tanishka-0/stm32_competition/PCB/3D.png

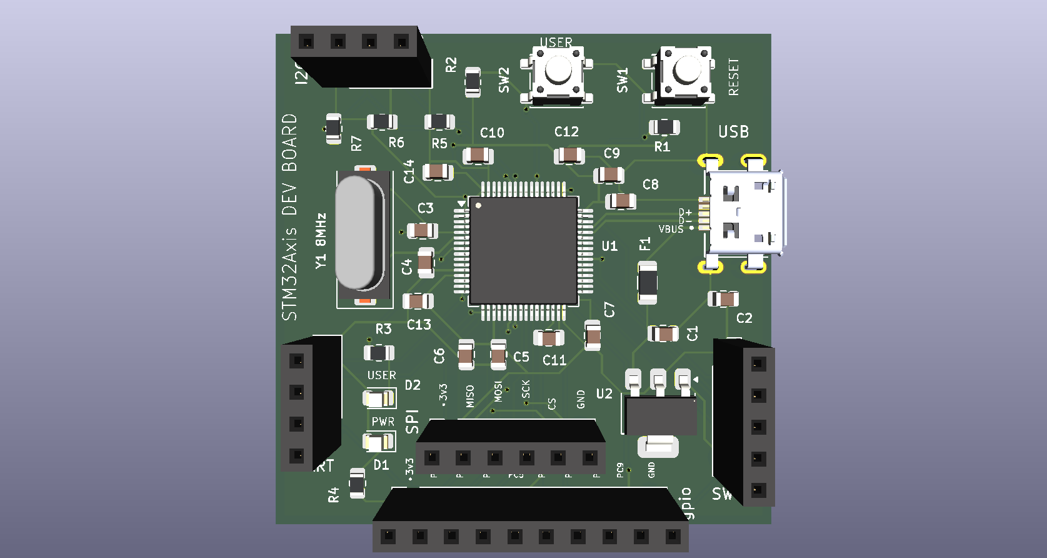
PCB/3D.png
