tanishka-0/stm32_competition/Documentation/DocumentReport.pdf

# STM32Axis Development Board

## Custom STM32F401RET6 Development Board made by team

## ERROR 505

### Project Documentation — Schematic, PCB Design, BOM & Validation Repository: github.com/tanishka-0/stm32axis

STM32Axis Development Board — Documentation | Page

## 1. Overview

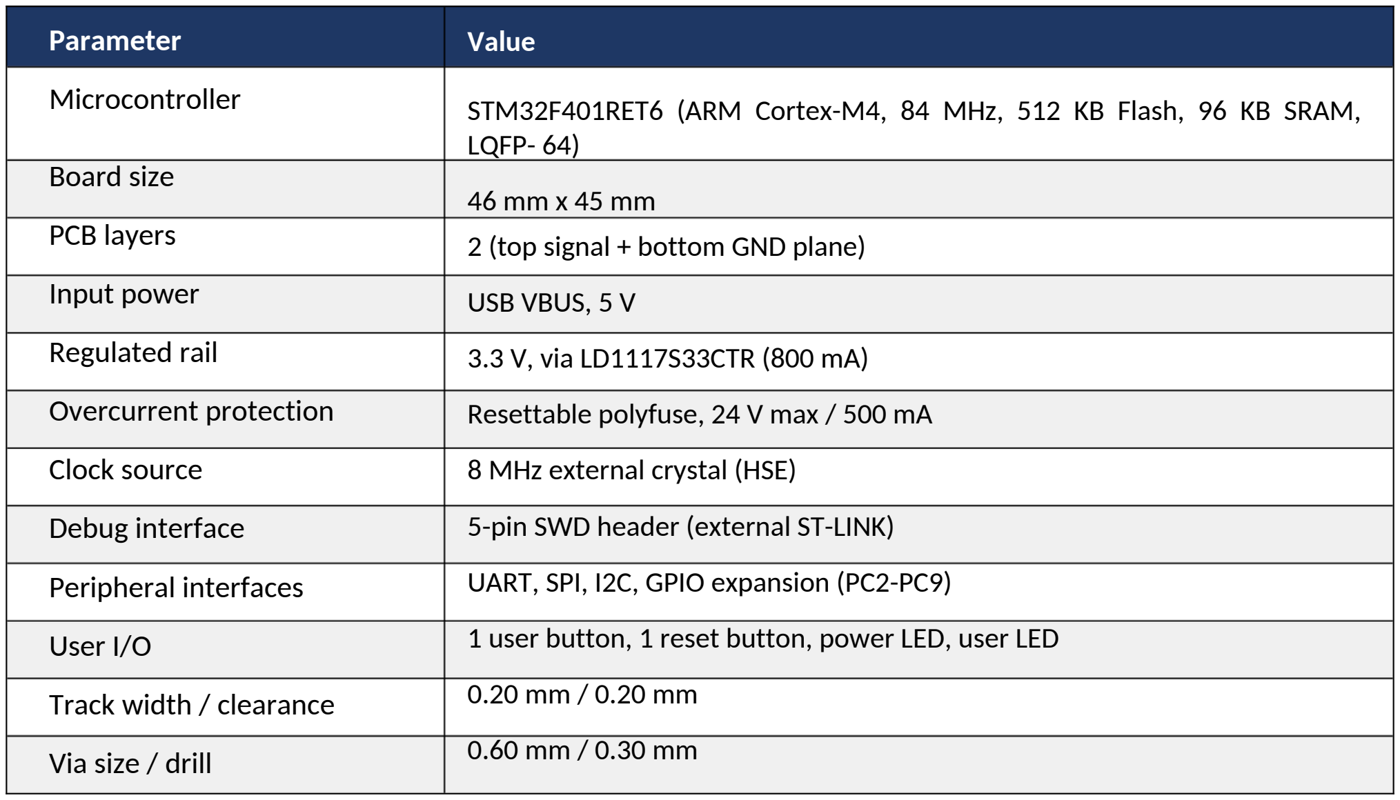
[picture p3: figure]
Parameter; Microcontroller; Board size; PCB layers; Input power; Regulated rail; Overcurrent protection; Clock source; Debug interface; Peripheral interfaces; User I/O; Track width / clearance; Via size / drill; Value; LQFP- 64); 2 (top signal + bottom GND plane); USB VBUS, 5 V; 3.3 V, via LD1117S33CTR (800 mA); Resettable polyfuse, 24 V max / 500 mA; 8 MHz external crystal (HSE); 5-pin SWD header (external ST-LINK)

## Proposed Solution

## Problem Statement

The objective is to design a compact and functional STM32-based evaluation and development board that provides the essential facilities required for programming, debugging, peripheral interfacing and generalpurpose embedded development. The design is inspired by the functionality and general architecture of the STM32 NUCLEO-F401RE while requiring an independently created schematic and PCB layout. The board must integrate the MCU, regulated power, programming/debug access, user controls and commonly used communicationinterfaces within a compact two-layer PCB.

Acustom developmentboard centered on the STM32F401RET6 ARM Cortex-M4 microcontroller is proposed. USB Micro-B provides the primary 5 V input and USB data connection. The input passes through a resettable polyfuse and is converted to a regulated 3.3 V rail using an LD1117S33CTR linear regulator. The MCU is

STM32Axis Development Board — Documentation | Page 2

The STM32Axis Development Board is a compact, two-layer STM32F401RET6 evaluation board designed as an independently engineered alternative to the STM32 NUCLEO-F401RE. It integrates the microcontroller, regulated power, external SWD debug access, user controls, and the commonly used communication interfaces (UART, SPI, I²C, GPIO) within a board size of 46 × 45 mm.

This document consolidates the complete design record for the board: problem statement and proposed solution, circuit architecture, functional block diagram, schematic, PCB layout and 3D render, bill of materials, power budget, firmware/usage notes, design considerations, and the electrical/design-rule validation performed on the project.

### Key Specifications

STM32F401RET6 (ARM Cortex-M4, 84 MHz, 512 KB Flash, 96 KB SRAM,

UART, SPI, I2C, GPIO expansion (PC2-PC9)

1 user button, 1 reset button, power LED, user LED

●
●
●
●
●

USB: D− and D+ connected to PA11 and PA12 respectively. UART: PA2 / PA3.
SPI: PA5 / PA6 / PA7 with a chip-select connection.
I²C: PB6 / PB7, with external 4.7 kΩ pull-ups.
GPIO expansion: PC2–PC9 exposed alongside 3.3 V and GND.

USB VBUS (5 V) -- resettable polyfuse -- 3.3 V LDO (LD1117S33CTR) -- common 3.3 V rail.
Regulator input/output capacitors support stable operation, while dedicated decoupling capacitors are provided at each MCU supply pin.

The STM32F401RET6 is the central processing device. An 8 MHz external crystal connected to the HSE oscillator pins provides the external high-speed clock source, with dedicated load capacitors placed close to the oscillator pins.

PA13/SWDIO and PA14/SWCLK are routed to a 5-pin SWD header together with target 3.3 V, NRST and GND, for connection to an external ST-LINK debugger.

programmed and debugged through an external ST-LINK using a dedicated SWD header, avoiding the additional circuitry and board area required for an onboard debugger.

The board also exposes UART, SPI and I²C interfaces and provides GPIO expansion, a user push button, reset control, power and user LEDs and an external 8 MHz crystal — creating a compact platform suitable for firmware development, peripheral experiments and embedded-system prototyping.

The diagram below summarises the board's functional architecture: the USB power/data entry point, the fuse and linear-regulator power chain feeding the 3.3 V rail, the STM32F401RE at the centre, the 8 MHz clock source, user-facing controls and indicators (user button, reset, power LED, user LED), and the peripheral headers (UART, SPI, I²C, SWD, GPIO expansion) fed from the MCU and the 3.3 V rail.

## Circuit Architecture

## 5. Functional Block Diagram

### 2.MCU and Clock

### 1.PowerSupply Chain

### 3.Programming and Debugging

### 4.USB and Peripheral Interfaces

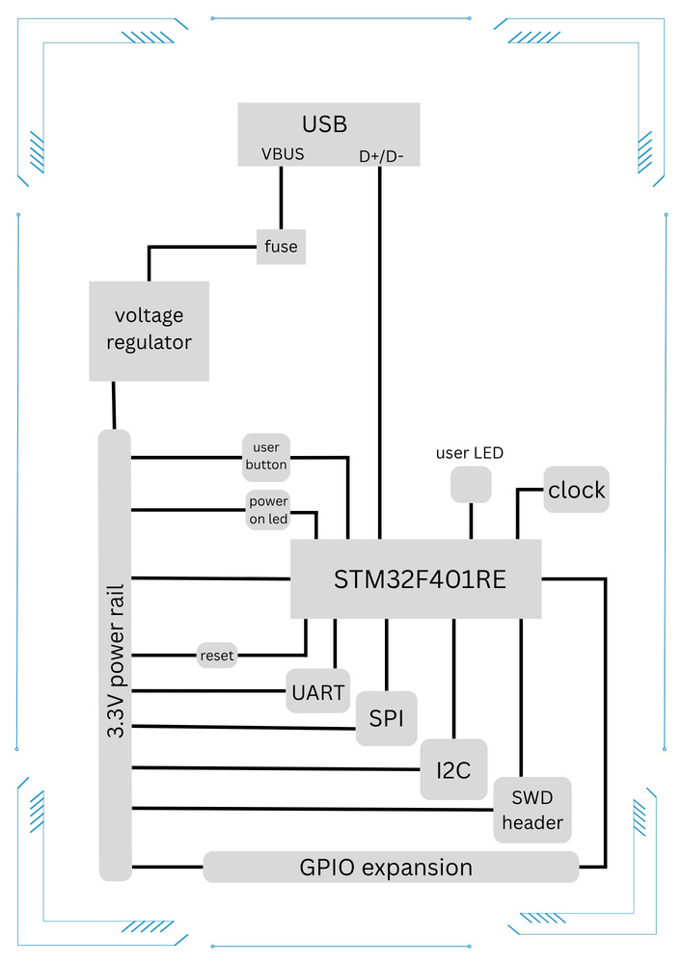
[picture p4: figure]

Figure — Functional block diagram of the STM32Axis Development Board

## 6. Schematic

The complete circuit schematic shows the STM32F401RET6, power regulation stage, USB interface, clock circuit, SWD debug header, and all peripheral connectors (UART, SPI, I²C, GPIO). The full schematic (KiCad) is included in the project repository.

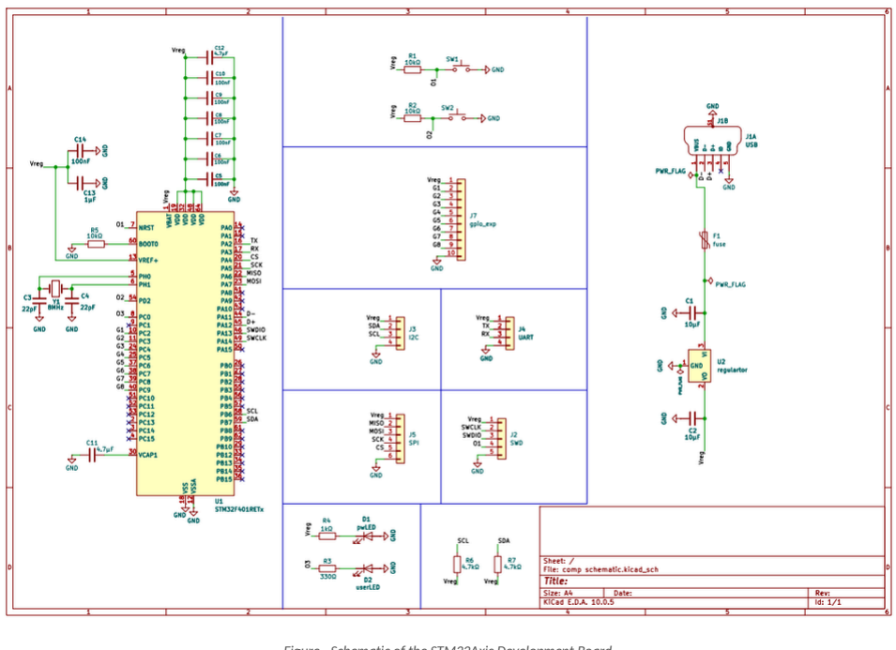
[picture p5: figure]

Figure - Schematic of the STM32Axis Development Board

## PCB Layout

The PCB is implemented as a two-layer board with the STM32F401RET6 placed near the centre and interface headers arranged around the board perimeter for accessibility. The USB connector and power-regulation section are placed together to keep the power path compact. The SWD header is positioned for connection to an external programmer/debugger, while UART, SPI, I²C and GPIO headers provide organised peripheral access.

The bottom copper layer is used substantially as a GND plane to provide a low-impedance return path and support signal integrity. Local decoupling components are placed close to the MCU supply pins. Routing was performed with a 0.20 mm track width and 0.20 mm clearance, with compact 0.60 mm vias (0.30 mm drill) where required. Silkscreen labels identify the major interfaces, controls and GPIO pins to improve usability; a '•' marks pin 1 on each communication connector for orientation.

## Bill of Materials

The boardis populated usingstandard 0805 passives and readily available connectors, keeping the design lowcost and easy to assemble. The full component list is summarised below; the complete BOM with vendor and pricing detail is included in the project repository.

A 3D render of the assembled board is included in the project repository, showing component placement for the MCU, USBconnector,crystal, buttons, LEDs and header rows.

### 3D Render

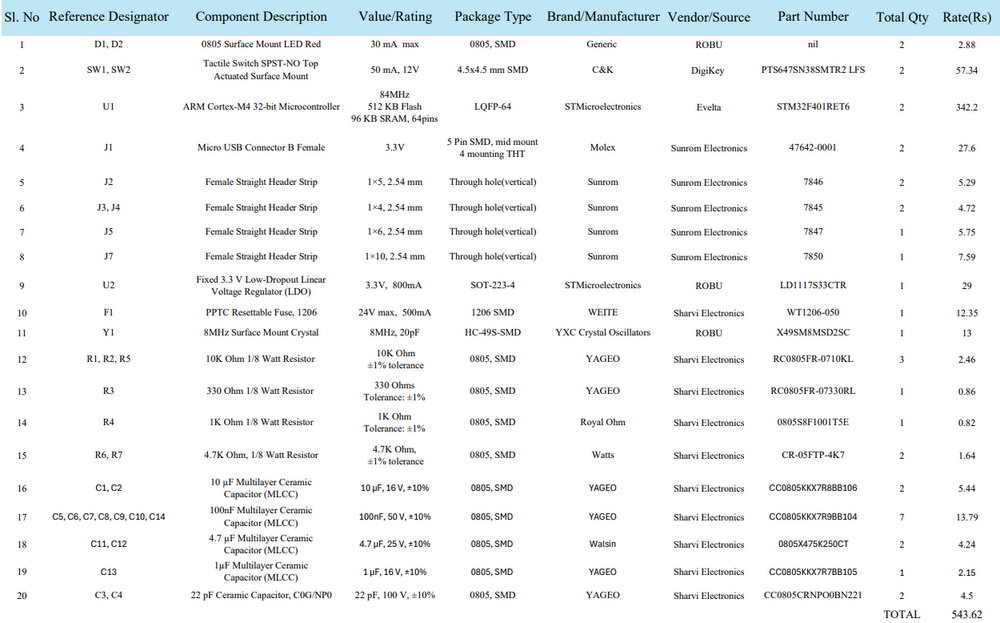
[picture p6: figure]

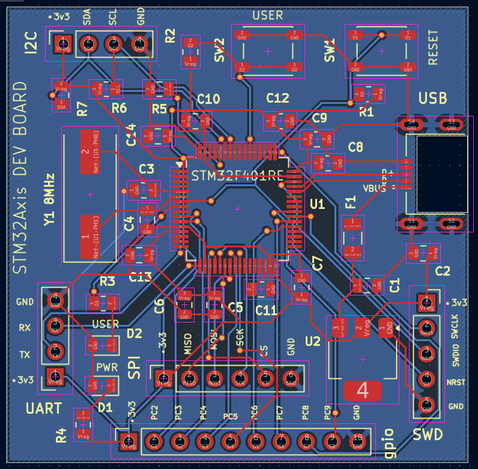
[picture p7: figure]

Figure — PCB layout of the STM32Axis Development Board

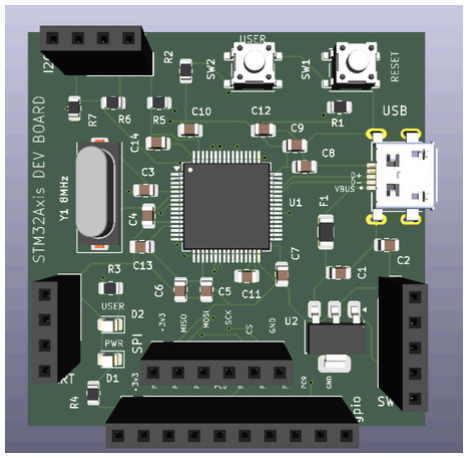
[picture p8: figure]

Figure —3D render image of the STM32Axis Development Board

## Major Components Summary

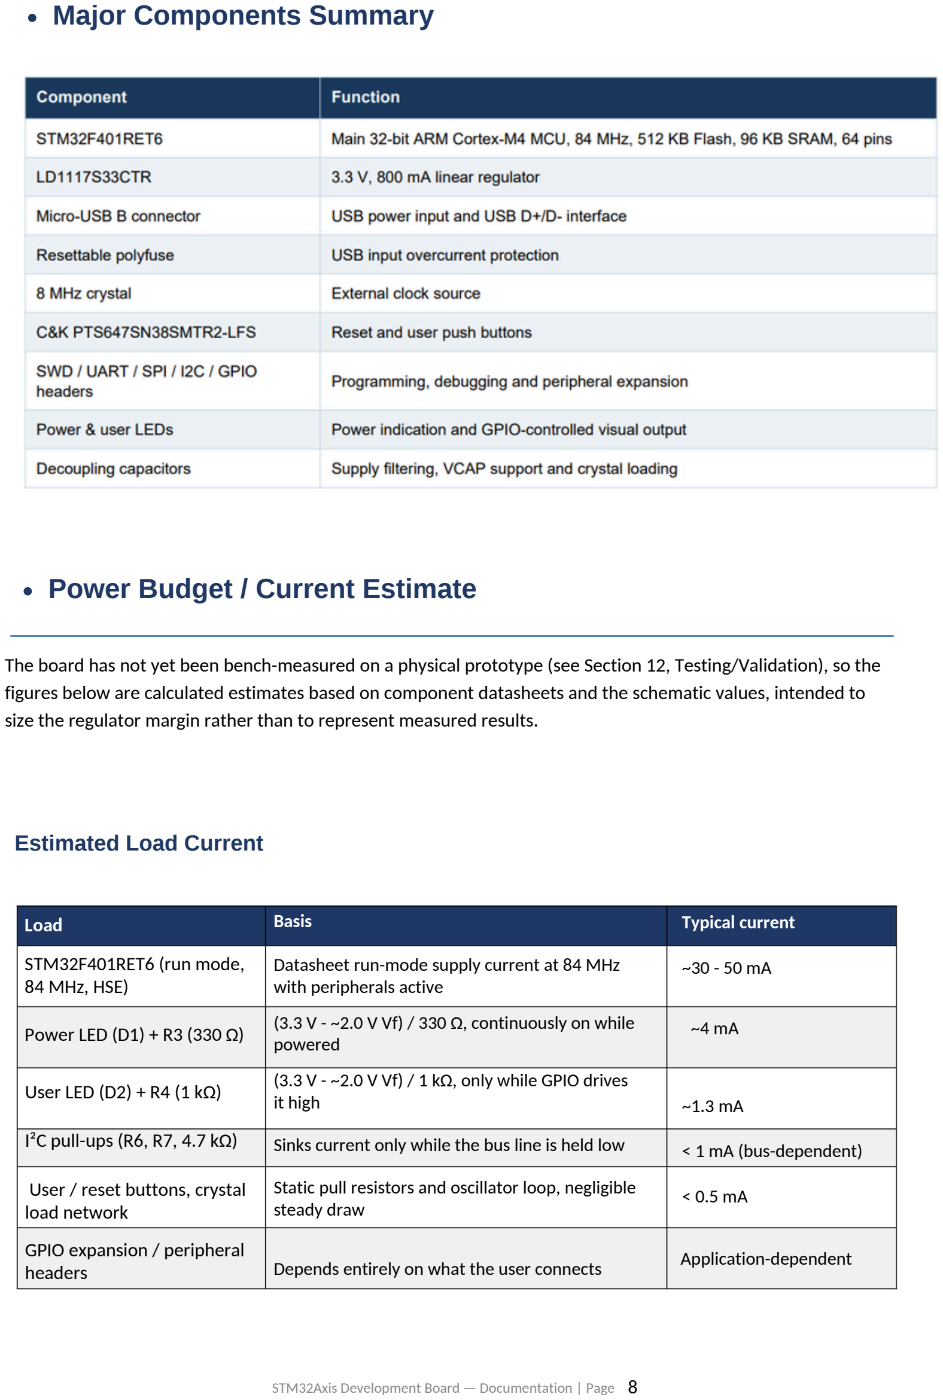
[picture p9: page 8]

The board has not yet been bench-measured on a physical prototype (see Section 12, Testing/Validation), so the figures below are calculated estimates based on component datasheets and the schematic values, intended to size the regulator margin rather than to represent measured results.

## Power Budget / Current Estimate

### Estimated Load Current

Load

STM32F401RET6 (run mode,
84 MHz, HSE)

Power LED (D1) + R3 (330 Ω)

User LED (D2) + R4 (1 kΩ)

I²C pull-ups (R6, R7, 4.7 kΩ)

User / reset buttons, crystal load network

GPIO expansion / peripheral headers

Basis

Datasheet run-mode supply current at 84 MHz with peripherals active

(3.3 V - ~2.0 V Vf) / 330 Ω, continuously on while powered

(3.3 V - ~2.0 V Vf) / 1 kΩ, only while GPIO drives it high

Sinks current only while the bus line is held low

Static pull resistors and oscillator loop, negligible steady draw

Depends entirely on what the user connects

Typical current

~30 - 50 mA

~4 mA

~1.3 mA

< 1 mA (bus-dependent)

< 0.5 mA

Application-dependent

# Design Considerations

•

•

•

•

•

•

•

Power: The 3.3Vrailisregulated fromUSB input and supported by local bulk and high-frequency decoupling.
MCU supply requirements: The STM32F401RET6 supply, VCAP1 and analog/reference decoupling follow the device hardware recommendations.
Clock integrity: The 8 MHz crystal and its load capacitors are kept close to the oscillator pins and routed with short connections.
Debug accessibility: SWD signals and target-voltage reference are exposed on a dedicated header for external ST-LINK use.
Signal integrity & manufacturability: Controlled routing rules, a continuous GND plane, appropriate clearances and compact via dimensions were used.
Usability: Interface headers and silkscreen labels are arranged to make common development connections easy to identify, with a '•' marking pin 1 on each connector.
Compactness: Functional blocks are placed to minimise unnecessary routing while maintaining accessibility and electrical separation.

## Testing / Validation

Validation was carried out at thedesignlevel using schematic connectivity checks (ERC) and PCB design-rule verification (DRC). Functional connections for USB, SWD, reset, clock, power and peripheral headers were also reviewed against the intended circuit architecture and STM32F401RE device requirements. As the project submission is based on PCB design, validation here refers to schematic and layout verification rather than physical prototype measurements.

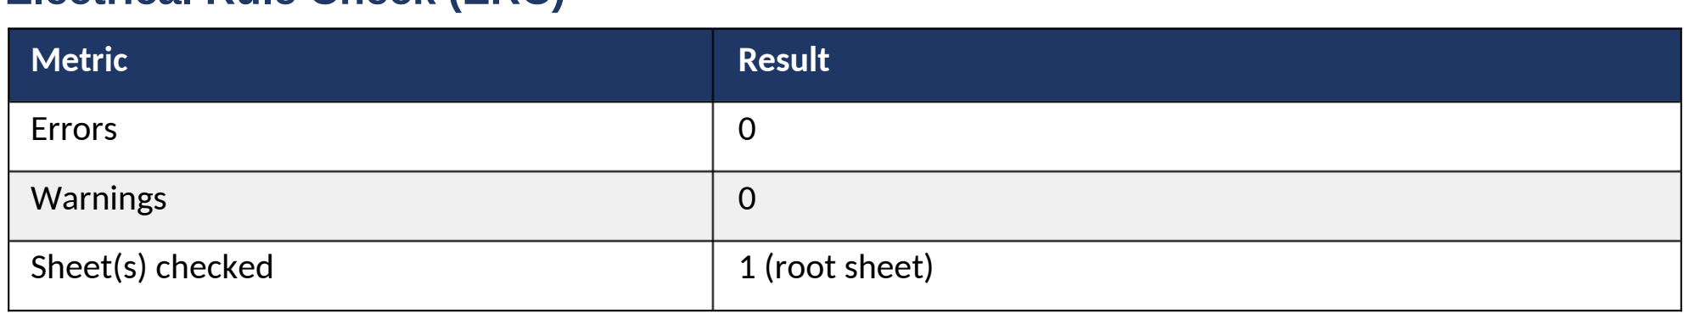
[picture p10: figure]
Metric; Errors; Warnings; Sheet(s) checked; Result; 1 (root sheet)

### Electrical Rule Check (ERC)

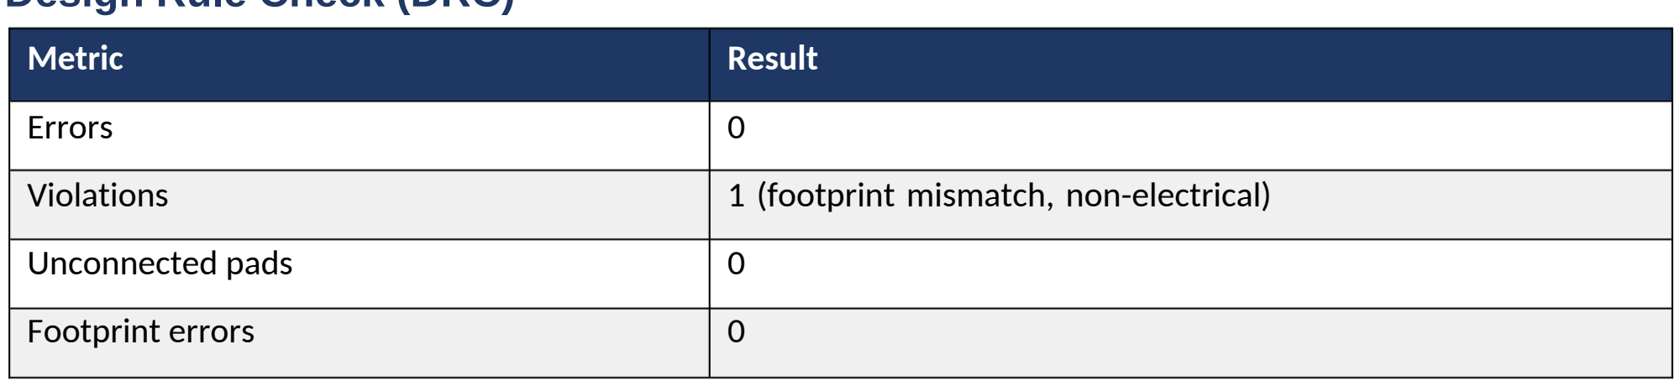
[picture p11: figure]
Metric; Errors; Violations; Unconnected pads; Footprint errors; Result; 1 (footprint mismatch, non-electrical)

The DRC run reported a single, non-electrical lib_footprint_mismatch warning for the USB connector footprint (local footprint override vs. library copy) — a labelling difference only, with no impact on connectivity. Zero unconnected pads and zero footprint errors were found; full DRC and ERC reports are provided in the project repository.

The ERC run found zero errors and zero warnings, confirming that all electrical connections in the schematic are complete and correctly defined.

### Design Rule Check (DRC)

## Peripheral Pin Mapping

The table below summarises the MCU pins routed to each connector, taken from the schematic.
Exact net names for the user button and user LED GPIOs should be confirmed against the schematic/netlist in the repository before writing firmware, as this summary does not repeat every housekeeping net.

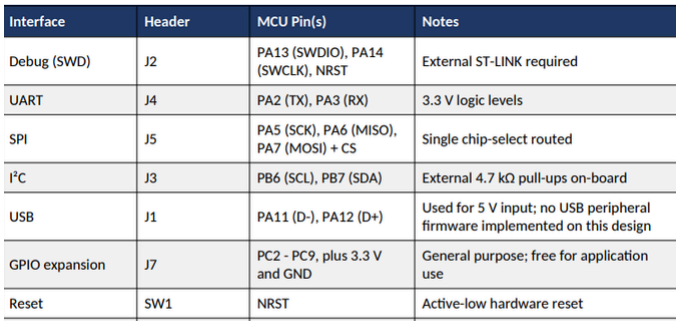
[picture p12: figure]

The main design challenges were fitting the required functionality into a compact two-layer board, maintaining adequate clearance around the LQFP-64 MCU, routing multiple peripheral interfaces and providing a practical ground-plane arrangement. Additional care was required for the MCU power and VCAP connections, USB routing, oscillator placement and external SWD accessibility. PCB rule violations encountered during layout were corrected by adjusting routing and clearances while retaining the intended functional architecture.

## Challenges

## Future Scope / Improvements

Onboard debugger: integrate an ST-LINK-compatible programmer on the board itself (as on the NUCLEO series) to remove the dependency on an external SWD probe.
USB protection: add ESD protection diodes and common-mode choke on the D+/D- lines, and reversepolarity/overvoltage protection on VBUS.
Power options: add a LiPo battery input with charge management for portable/battery-powered use cases, and a power-path switch between USB and battery.
Expanded peripheral breakout: label and expose additional timer/PWM-capable and ADC-capable pins, and consider a CAN transceiver footprint or SD-card slot for more advanced projects.
Stack-up: consider a 4-layer PCB with dedicated power and ground planes if higher-speed peripherals (e.g. USB high-speed, higher-rate SPI) are added, for improved EMI and signal integrity.

## Final Outcome

Theresulting design is a compact STM32F401RET6 development board, sized 46 × 45 mm, that combines regulated 3.3 V power, USB connectivity, external SWD programming/debugging, clock circuitry, reset and user controls, status indication, and UART, SPI, I²C and GPIO expansion in a two-layer PCB. The design is organised for practical embedded development while retaining a compact form and clear user-facing interface labelling.

The completed schematic, PCB layout, BOM, verification reports and visual renders are available in the project

repository:

https://github.com/tanishka-0/stm32axis
