tanishka-0/stm32_competition/BOM/STM32BOM.pdf

Sl. No | Vendor/Source | Total Qty Rate(Rs)
1 | ROBU | 2 | 2.88
2 | DigiKey | 2 | 57.34
3 | Evelta | 2 | 342.2
4 | Sunrom Electronics | 2 | 27.6
5 | Sunrom Electronics | 2 | 5.29
6 | Sunrom Electronics | 2 | 4.72
7 | Sunrom Electronics | 1 | 5.75
8 | Sunrom Electronics | 1 | 7.59
9 | ROBU | 1 | 29
10 | Sharvi Electronics | 1 | 12.35
11 | ROBU | 1 | 13
12 | Sharvi Electronics | 3 | 2.46
13 | Sharvi Electronics | 1 | 0.86
14 | Sharvi Electronics | 1 | 0.82
15 | Sharvi Electronics | 2 | 1.64
16 | Sharvi Electronics | 2 | 5.44
17 | Sharvi Electronics | 7 | 13.79
18 | Sharvi Electronics | 2 | 4.24
19 | Sharvi Electronics | 1 | 2.15
20 | Sharvi Electronics | 2 | 4.5
| | TOTAL | 543.62

CC0805KKX7R8BB106

CC0805KKX7R9BB104

0805X475K250CT

CC0805KKX7R7BB105

CC0805CRNPO0BN221

0805, SMD

0805, SMD

YAGEO

YAGEO

Walsin

YAGEO

0805, SMD | YAGEO

0805, SMD

0805, SMD

### 10 µF, 16 V, ±10%

100nF, 50 V, ±10%

### 4.7 µF, 25 V, ±10%

### 1 µF, 16 V, ±10%

### 22 pF, 100 V, ±10%

### 10 µF Multilayer Ceramic

Capacitor (MLCC)
100nF Multilayer Ceramic
Capacitor (MLCC)

### 4.7 µF Multilayer Ceramic

Capacitor (MLCC)
1µF Multilayer Ceramic
Capacitor (MLCC)

### 22 pF Ceramic Capacitor, C0G/NP0

C1, C2

C5, C6, C7, C8, C9, C10, C14

C11, C12

C13

C3, C4

Reference Designator | Component Description | Value/Rating | Package Type Brand/Manufacturer | Part Number
| 0805 Surface Mount LED Red Tactile Switch SPST-NO Top Actuated Surface Mount
| ARM Cortex-M4 32-bit Microcontroller | | | nil

Micro USB Connector B Female

Female Straight Header Strip

F1

D1, D2

SW1, SW2

J1

U1

J2

J3, J4

J7

J5

U2

Female Straight Header Strip

Female Straight Header Strip

Female Straight Header Strip

Fixed 3.3 V Low-Dropout Linear Voltage Regulator (LDO)

PPTC Resettable Fuse, 1206

Y1

R3

R1, R2, R5

R6, R7

R4

### 30 mA max

### 50 mA, 12V

84MHz
512 KB Flash

### 96 KB SRAM, 64pins

3.3V

1×5, 2.54 mm

8MHz Surface Mount Crystal

10K Ohm 1/8 Watt Resistor

330 Ohm 1/8 Watt Resistor

1K Ohm 1/8 Watt Resistor

4.7K Ohm, 1/8 Watt Resistor | 4.7K Ohm, ±1% tolerance 330 Ohms Tolerance: ±1% 10K Ohm ±1% tolerance

3.3V, 800mA

24V max, 500mA

1×4, 2.54 mm

1×6, 2.54 mm

1×10, 2.54 mm

8MHz, 20pF

1K Ohm
Tolerance: ±1%

1206 SMD

0805, SMD

0805, SMD

0805, SMD

0805, SMD

HC-49S-SMD

SOT-223-4

Through hole(vertical)

### 5 Pin SMD, mid mount 4 mounting THT

Generic

C&K

STMicroelectronics

Sunrom

Sunrom

Sunrom

Molex

0805, SMD

4.5x4.5 mm SMD

LQFP-64

Through hole(vertical)

Through hole(vertical)

Through hole(vertical)

Sunrom

YXC Crystal Oscillators

YAGEO

Royal Ohm

Watts

YAGEO

STMicroelectronics

WEITE

7847

WT1206-050

X49SM8MSD2SC

RC0805FR-0710KL

47642-0001

7845

PTS647SN38SMTR2 LFS

STM32F401RET6

7846

CR-05FTP-4K7

0805S8F1001T5E

RC0805FR-07330RL

LD1117S33CTR

7850
