tanishka-0/stm32_competition/Schematic/comp schematic.pdf

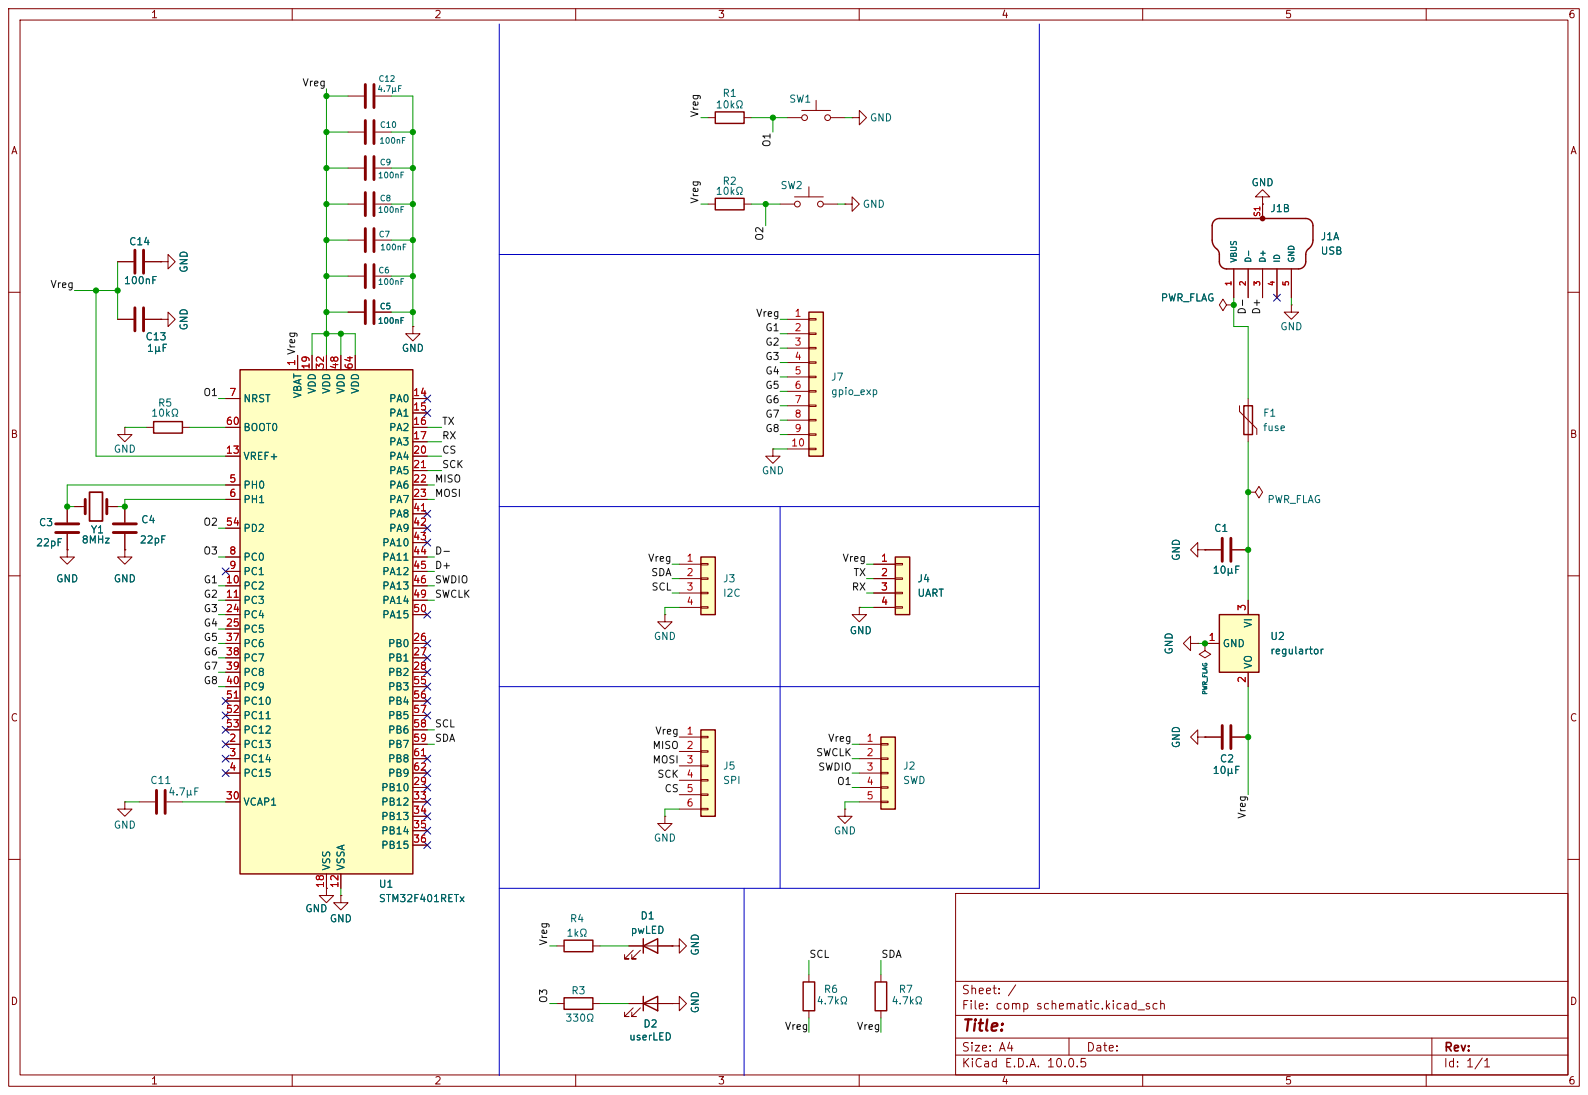
[picture p13: page 1]

Vreg SCL RX MISO
SCK MOSI SWDIO

Size: A4 | Rev:
KiCad E.D.A. 10.0.5 | Id: 1/1
