tanishka-0/stm32_competition/PCB/comp pcb1.kicad_pcb

## KiCad design PCB/comp pcb1.kicad_pcb (2026-09-16)

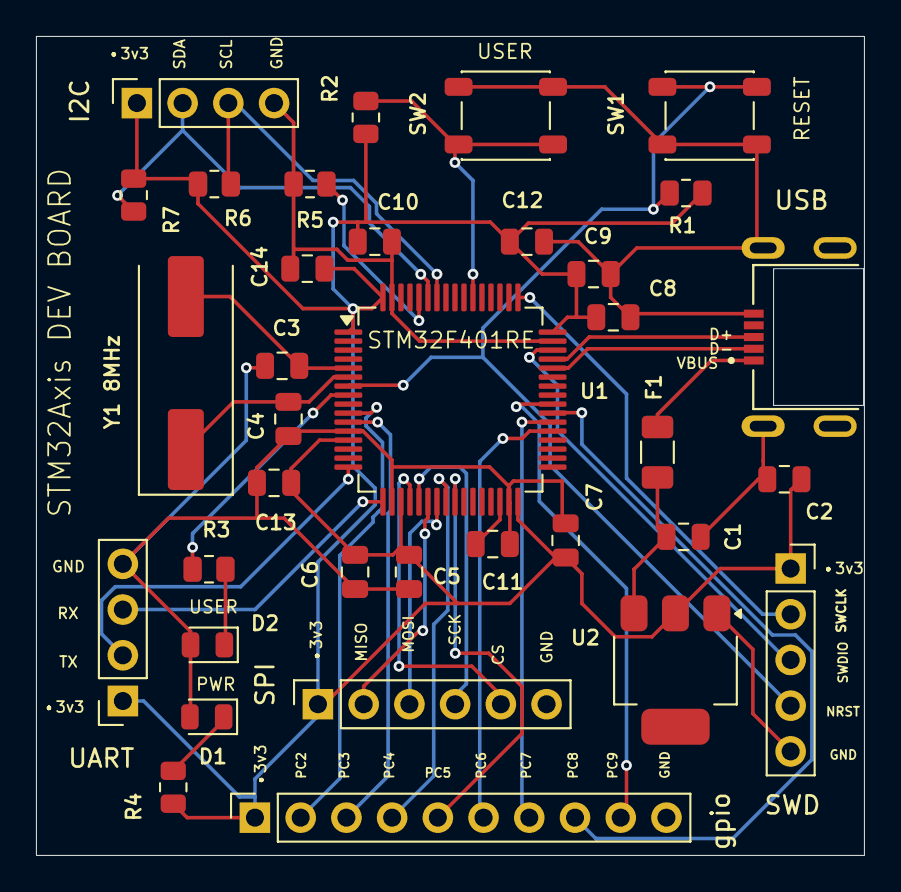
[picture p14: board comp pcb1.kicad_pcb from above]

Board: 2 copper layers, 46.0 x 45.5 mm, 35 parts (0 on the bottom side), 33 nets.

Parts:
C1, C2: 10µF; C_0805_2012Metric
C3, C4: C; C_0805_2012Metric
C5, C6, C7, C8, C9, C10, C14: 100nF; C_0805_2012Metric
C11, C12: 4.7µF; C_0805_2012Metric
C13: 1µF; C_0805_2012Metric
D1: pwLED; LED_0805_2012Metric
D2: userLED; LED_0805_2012Metric
F1: fuse; Fuse_1206_3216Metric
I2C: I2C; PinSocket_1x04_P2.54mm_Vertical
R1, R2, R5: 10kΩ; R_0805_2012Metric
R3: 330Ω; R_0805_2012Metric
R4: 1kΩ; R_0805_2012Metric
R6, R7: 4.7kΩ; R_0805_2012Metric
SPI: SPI; PinSocket_1x06_P2.54mm_Vertical
SW1, SW2: SW_Push; SW_SPST_PTS647_Sx38
SWD: SWD; PinSocket_1x05_P2.54mm_Vertical
U1: STM32F401RETx; LQFP-64_10x10mm_P0.5mm
U2: regulartor; SOT-223
UART: UART; PinSocket_1x04_P2.54mm_Vertical
USB: USB; MOLEX_47642-0001
Y1 8MHz: 8MHz; Crystal_SMD_HC49-SD
gpio: gpio_exp; PinSocket_1x10_P2.54mm_Vertical

Connections:
/CS: SPI.5, U1.20 (PA4)
/D+: U1.45 (PA12), USB.3 (D+)
/D-: U1.44 (PA11), USB.2 (D-)
/G1: U1.10 (PC2), gpio.2
/G2: U1.11 (PC3), gpio.3
/G3: U1.24 (PC4), gpio.4
/G4: U1.25 (PC5), gpio.5
/G5: U1.37 (PC6), gpio.6
/G6: U1.38 (PC7), gpio.7
/G7: U1.39 (PC8), gpio.8
/G8: U1.40 (PC9), gpio.9
/MISO: SPI.2, U1.22 (PA6)
/MOSI: SPI.3, U1.23 (PA7)
/O1: R1.2, SW1.1, SWD.4, U1.7 (NRST)
/O2: R2.2, SW2.1, U1.54 (PD2)
/O3: R3.1, U1.8 (PC0)
/RX: U1.17 (PA3), UART.3
/SCK: SPI.4, U1.21 (PA5)
/SCL: I2C.3, R6.1, U1.58 (PB6)
/SDA: I2C.2, R7.1, U1.59 (PB7)
/SWCLK: SWD.2, U1.49 (PA14)
/SWDIO: SWD.3, U1.46 (PA13)
/TX: U1.16 (PA2), UART.2
/Vreg: C2.1, C5.1, C6.1, C7.1, C8.1, C9.1, C10.1, C12.1, C13.1, C14.1, I2C.1, R1.1, R2.1, R4.1, R6.2, R7.2, SPI.1, SWD.1, U1.1 (VBAT), U1.13 (VREF+), U1.19 (VDD), U1.32 (VDD), U1.48 (VDD), U1.64 (VDD), U2.2 (VO), UART.1, gpio.1
GND: C1.2, C2.2, C3.1, C4.2, C5.2, C6.2, C7.2, C8.2, C9.2, C10.2, C11.1, C12.2, C13.2, C14.2, D1.2 (A), D2.2 (A), I2C.4, R5.1, SPI.6, SW1.2, SW2.2, SWD.5, U1.12 (VSSA), U1.18 (VSS), U1.31 (VSS), U1.47 (VSS), U1.63 (VSS), U2.1 (GND), UART.4, USB.5 (GND), USB.S1, USB.S2, USB.S3, USB.S4, gpio.10
unnamed: D1.1 (K), R4.2
unnamed: D2.1 (K), R3.2
unnamed: F1.1, USB.1 (VBUS)
unnamed: R5.2, U1.60 (BOOT0)
unnamed: C3.2, U1.5 (PH0), Y1 8MHz.2
unnamed: C4.1, U1.6 (PH1), Y1 8MHz.1
unnamed: C11.2, U1.30 (VCAP1)
unnamed: C1.1, F1.2, U2.3 (VI)
